rijn/smart-blind-control/control_board/datasheets/diagram.png

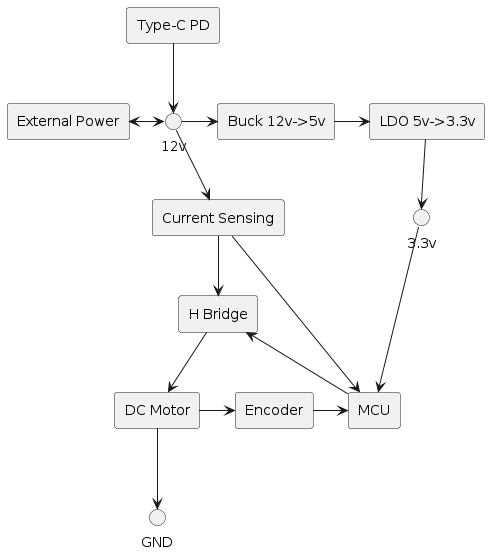
control_board/datasheets/diagram.png
