rijn/smart-blind-control/control_board/datasheets/O1CN01RWz3fV1wqTMmvift8_!!2208043386359.jpg

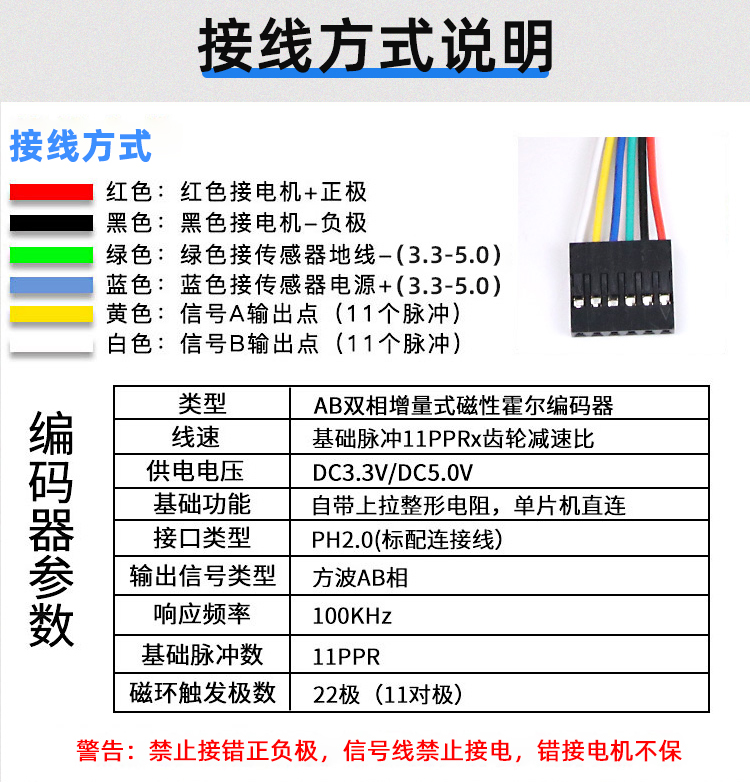
control_board/datasheets/O1CN01RWz3fV1wqTMmvift8_!!2208043386359.jpg
