rijn/smart-blind-control/(list of files, cad)

Other CAD files:
case/blind control.f3z
