rijn/smart-blind-control/control_board/control_board.kicad_pcb

## KiCad design control_board/control_board.kicad_pcb (2024-06-19)

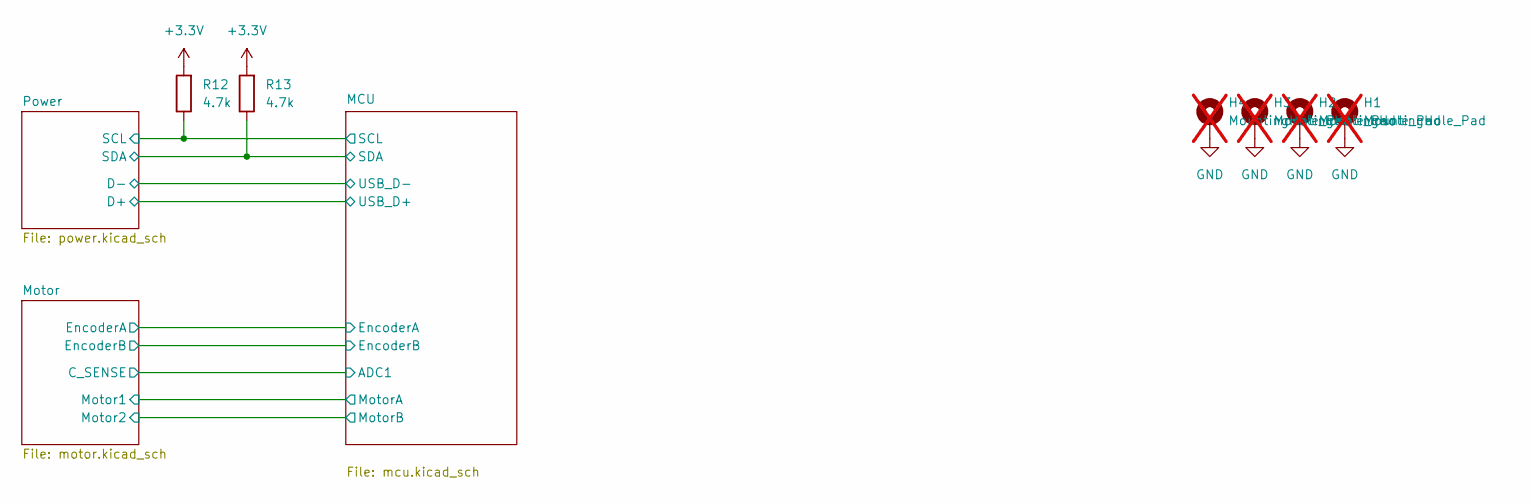
[picture p3: schematic control_board.kicad_sch]

Parts:
H1, H2, H3, H4: MountingHole_Pad; MountingHole_2.2mm_M2_Pad; not fitted
R12, R13: 4.7k; R_0603_1608Metric; LCSC Part# C23162

Connections:
+3.3V: R12.2, R13.2; also elsewhere on the board
/MCU/SCL: R12.1; also elsewhere on the board
/MCU/SDA: R13.1; also elsewhere on the board
GND: H1.1, H2.1, H3.1, H4.1; also elsewhere on the board

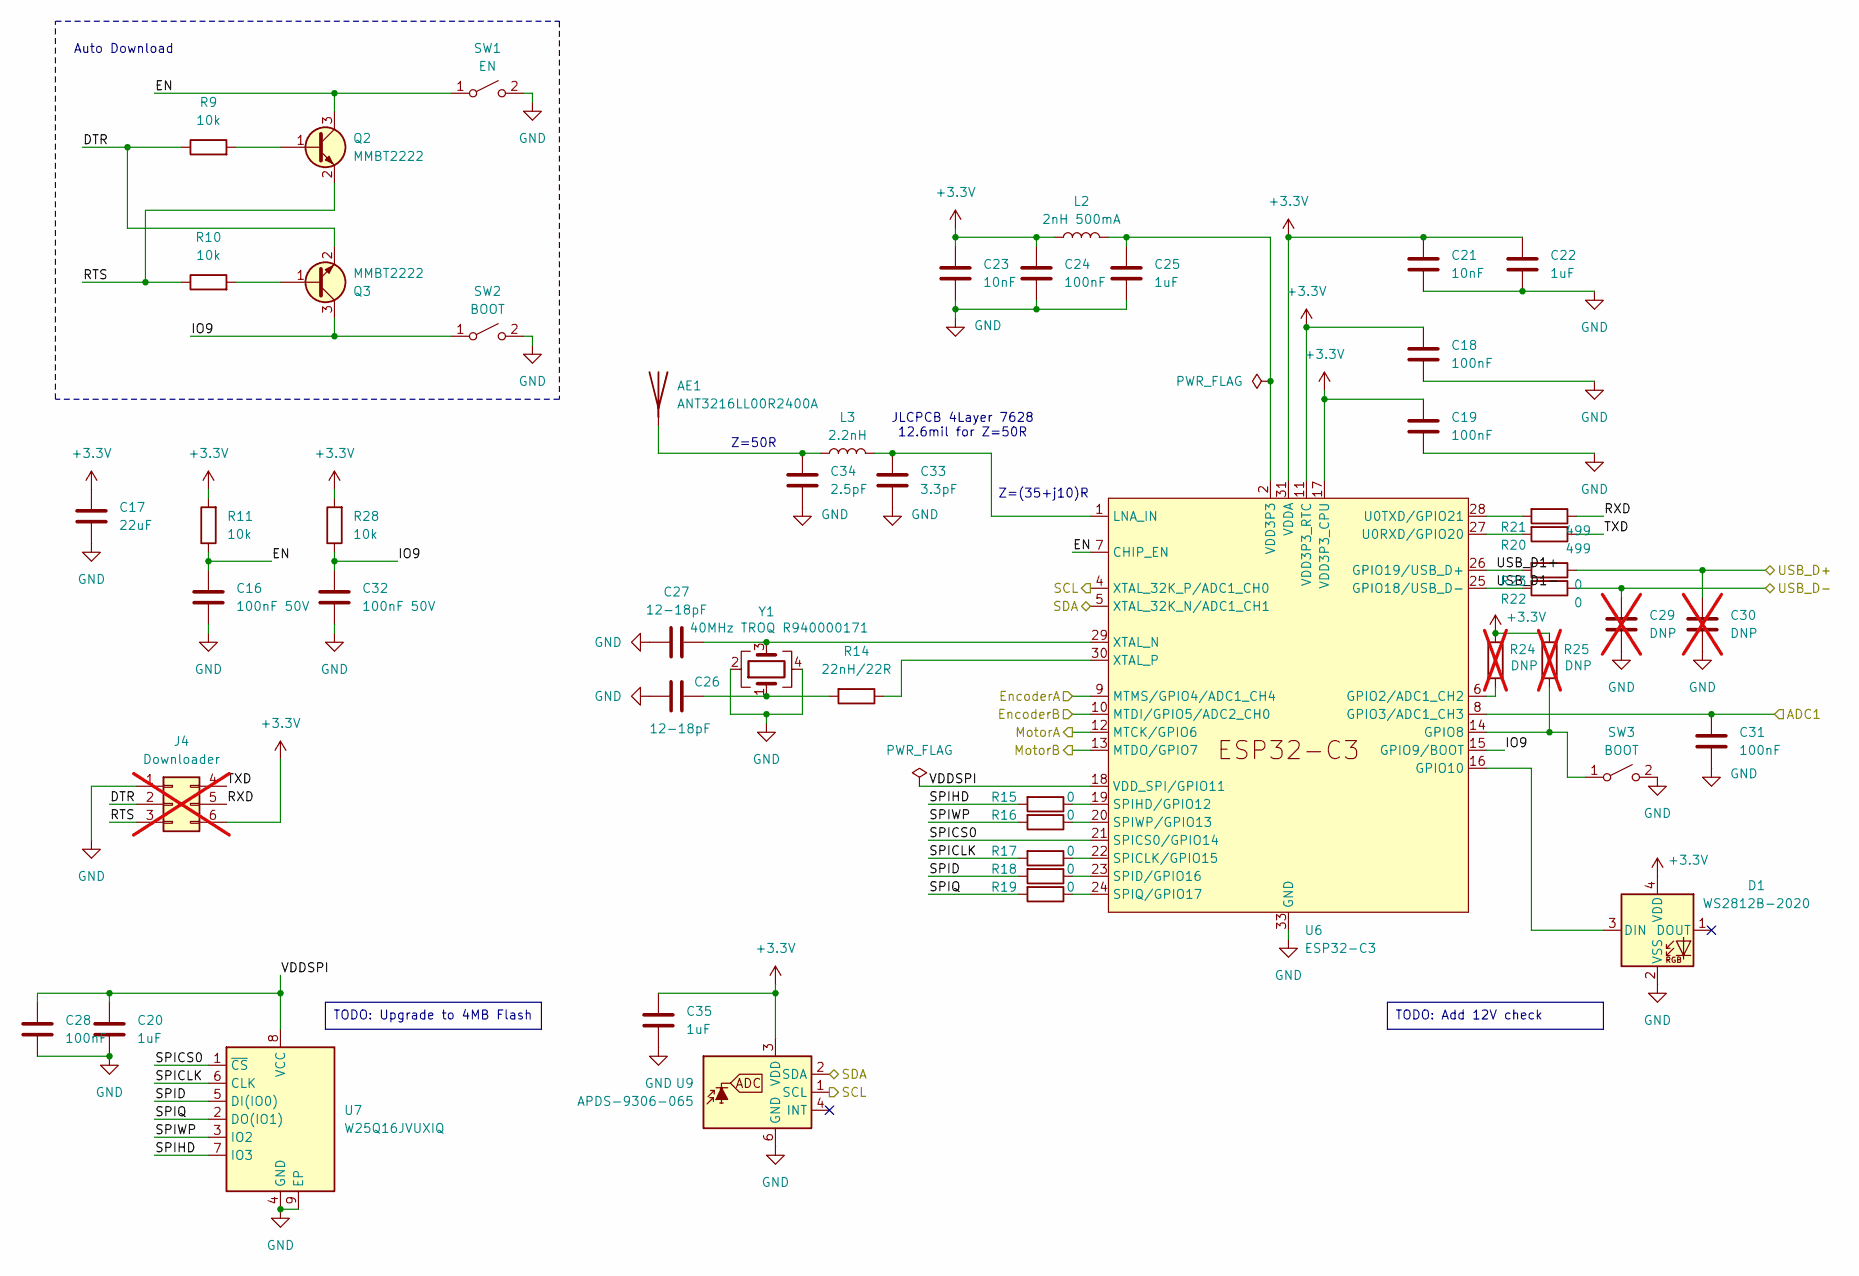
[picture p4: schematic mcu.kicad_sch]

Parts:
AE1: ANT3216LL00R2400A; LCSC Part# C293767
C16, C32: 100nF 50V; C_0603_1608Metric; LCSC Part# C14663
C17: 22uF; C_0805_2012Metric; LCSC Part# C45783
C18, C19, C24, C28, C31: 100nF; C_0603_1608Metric; LCSC Part# C14663
C20, C22, C25, C35: 1uF; C_0603_1608Metric; LCSC Part# C15849
C21, C23: 10nF; C_0603_1608Metric; LCSC Part# C57112
C26, C27: 12-18pF; C_0603_1608Metric; LCSC Part# C38523
C29, C30: DNP; C_0603_1608Metric; not fitted
C33: 3.3pF; C_0402_1005Metric; LCSC Part# C710652
C34: 2.5pF; C_0402_1005Metric; LCSC Part# C2189359
D1: WS2812B-2020; LED_WS2812B-2020_PLCC4_2.0x2.0mm; LCSC Part# C5349955
J4: Downloader; PinHeader_2x03_P2.54mm_Vertical; not fitted
L2: 2nH 500mA; L_0603_1608Metric; LCSC Part# C280268
L3: 2.2nH; L_0402_1005Metric; LCSC Part# C86061
Q2, Q3: MMBT2222; SOT-23; LCSC Part# C8512
R9, R10, R11, R28: 10k; R_0603_1608Metric; LCSC Part# C25804
R14: 22nH/22R; R_0603_1608Metric; LCSC Part# C23345
R15, R16, R17, R18, R19: 0; R_0402_1005Metric; LCSC Part# C17168
R20, R21: 499; R_0603_1608Metric; LCSC Part# C23193
R22, R23: 0; R_0603_1608Metric; LCSC Part# C21189
R24, R25: DNP; R_0603_1608Metric; not fitted
SW1: EN; SW_SPST_CK_KMS2xxGP; LCSC Part# C221701
SW2, SW3: BOOT; SW_SPST_CK_KMS2xxGP; LCSC Part# C221701
U6: ESP32-C3; QFN-32-1EP_5x5mm_P0.5mm_EP3.45x3.45mm; LCSC Part# C2838500
U7: W25Q16JVUXIQ; Winbond_USON-8-1EP_3x2mm_P0.5mm_EP0.2x1.6mm; LCSC Part# C2843335
U9: APDS-9306-065; Broadcom_DFN-6_2x2mm_P0.65mm; LCSC Part # C2649498
Y1: 40MHz TROQ R940000171; Crystal_SMD_2016-4Pin_2.0x1.6mm; LCSC Part# C2929402

Connections:
+3.3V: C17.1, C18.1, C19.1, C21.1, C22.1, C23.1, C24.1, C35.1, D1.4 (VDD), J4.6, L2.1, R11.2, R24.1, R25.1, R28.2, U6.11 (VDD3P3_RTC), U6.17 (VDD3P3_CPU), U6.31 (VDDA), U6.32 (VDDA), U9.3 (VDD); also elsewhere on the board
/MCU/ADC1: C31.1, U6.8 (GPIO3/ADC1_CH3); also elsewhere on the board
/MCU/DTR: J4.2, Q3.2 (E), R9.1
/MCU/EN: C16.1, Q2.3 (C), R11.1, SW1.1 (A), U6.7 (CHIP_EN)
/MCU/EncoderA: U6.9 (MTMS/GPIO4/ADC1_CH4); also elsewhere on the board
/MCU/EncoderB: U6.10 (MTDI/GPIO5/ADC2_CH0); also elsewhere on the board
/MCU/IO9: C32.1, Q3.3 (C), R28.1, SW2.1 (A), U6.15 (GPIO9/BOOT)
/MCU/MotorA: U6.12 (MTCK/GPIO6); also elsewhere on the board
/MCU/MotorB: U6.13 (MTDO/GPIO7); also elsewhere on the board
/MCU/RTS: J4.3, Q2.2 (E), R10.1
/MCU/RXD: J4.5, R21.1
/MCU/SCL: U6.4 (XTAL_32K_P/ADC1_CH0), U9.1 (SCL); also elsewhere on the board
/MCU/SDA: U6.5 (XTAL_32K_N/ADC1_CH1), U9.2 (SDA); also elsewhere on the board
/MCU/SPICLK: R17.2, U7.6 (CLK)
/MCU/SPICS0: U6.21 (SPICS0/GPIO14), U7.1 (~CS)
/MCU/SPID: R18.2, U7.5 (DI(IO0))
/MCU/SPIHD: R15.2, U7.7 (IO3)
/MCU/SPIQ: R19.2, U7.2 (DO(IO1))
/MCU/SPIWP: R16.2, U7.3 (IO2)
/MCU/TXD: J4.4, R20.1
/MCU/USB_D1+: R23.2, U6.26 (GPIO19/USB_D+)
/MCU/USB_D1-: R22.2, U6.25 (GPIO18/USB_D-)
/MCU/USB_D+: C30.1, R23.1; also elsewhere on the board
/MCU/USB_D-: C29.1, R22.1; also elsewhere on the board
/MCU/VDDSPI: C20.1, C28.1, U6.18 (VDD_SPI/GPIO11), U7.8 (VCC)
GND: C16.2, C17.2, C18.2, C19.2, C20.2, C21.2, C22.2, C23.2, C24.2, C25.2, C26.1, C27.1, C28.2, C29.2, C30.2, C31.2, C32.2, C33.2, C34.2, C35.2, D1.2 (VSS), J4.1, SW1.2 (B), SW2.2 (B), SW3.2 (B), U6.33 (GND), U7.4 (GND), U7.9 (EP), U9.6 (GND), Y1.2, Y1.4; also elsewhere on the board
unnamed: AE1.1 (A), C34.1, L3.1
unnamed: C25.1, L2.2, U6.2 (VDD3P3), U6.3 (VDD3P3)
unnamed: C26.2, R14.2, Y1.1
unnamed: D1.3 (DIN), U6.16 (GPIO10)
unnamed: Q2.1 (B), R9.2
unnamed: Q3.1 (B), R10.2
unnamed: R25.2, SW3.1 (A), U6.14 (GPIO8)
unnamed: R24.2, U6.6 (GPIO2/ADC1_CH2)
unnamed: C33.1, L3.2, U6.1 (LNA_IN)
unnamed: R17.1, U6.22 (SPICLK/GPIO15)
unnamed: R18.1, U6.23 (SPID/GPIO16)
unnamed: R15.1, U6.19 (SPIHD/GPIO12)
unnamed: R19.1, U6.24 (SPIQ/GPIO17)
unnamed: R16.1, U6.20 (SPIWP/GPIO13)
unnamed: R20.2, U6.27 (U0RXD/GPIO20)
unnamed: R21.2, U6.28 (U0TXD/GPIO21)
unnamed: C27.2, U6.29 (XTAL_N), Y1.3
unnamed: R14.1, U6.30 (XTAL_P)

Notes on the sheet:
TODO: Add 12V check
TODO: Upgrade to 4MB Flash
JLCPCB 4Layer 7628 12.6mil for Z=50R
Z=50R
Auto Download
Z=(35+j10)R

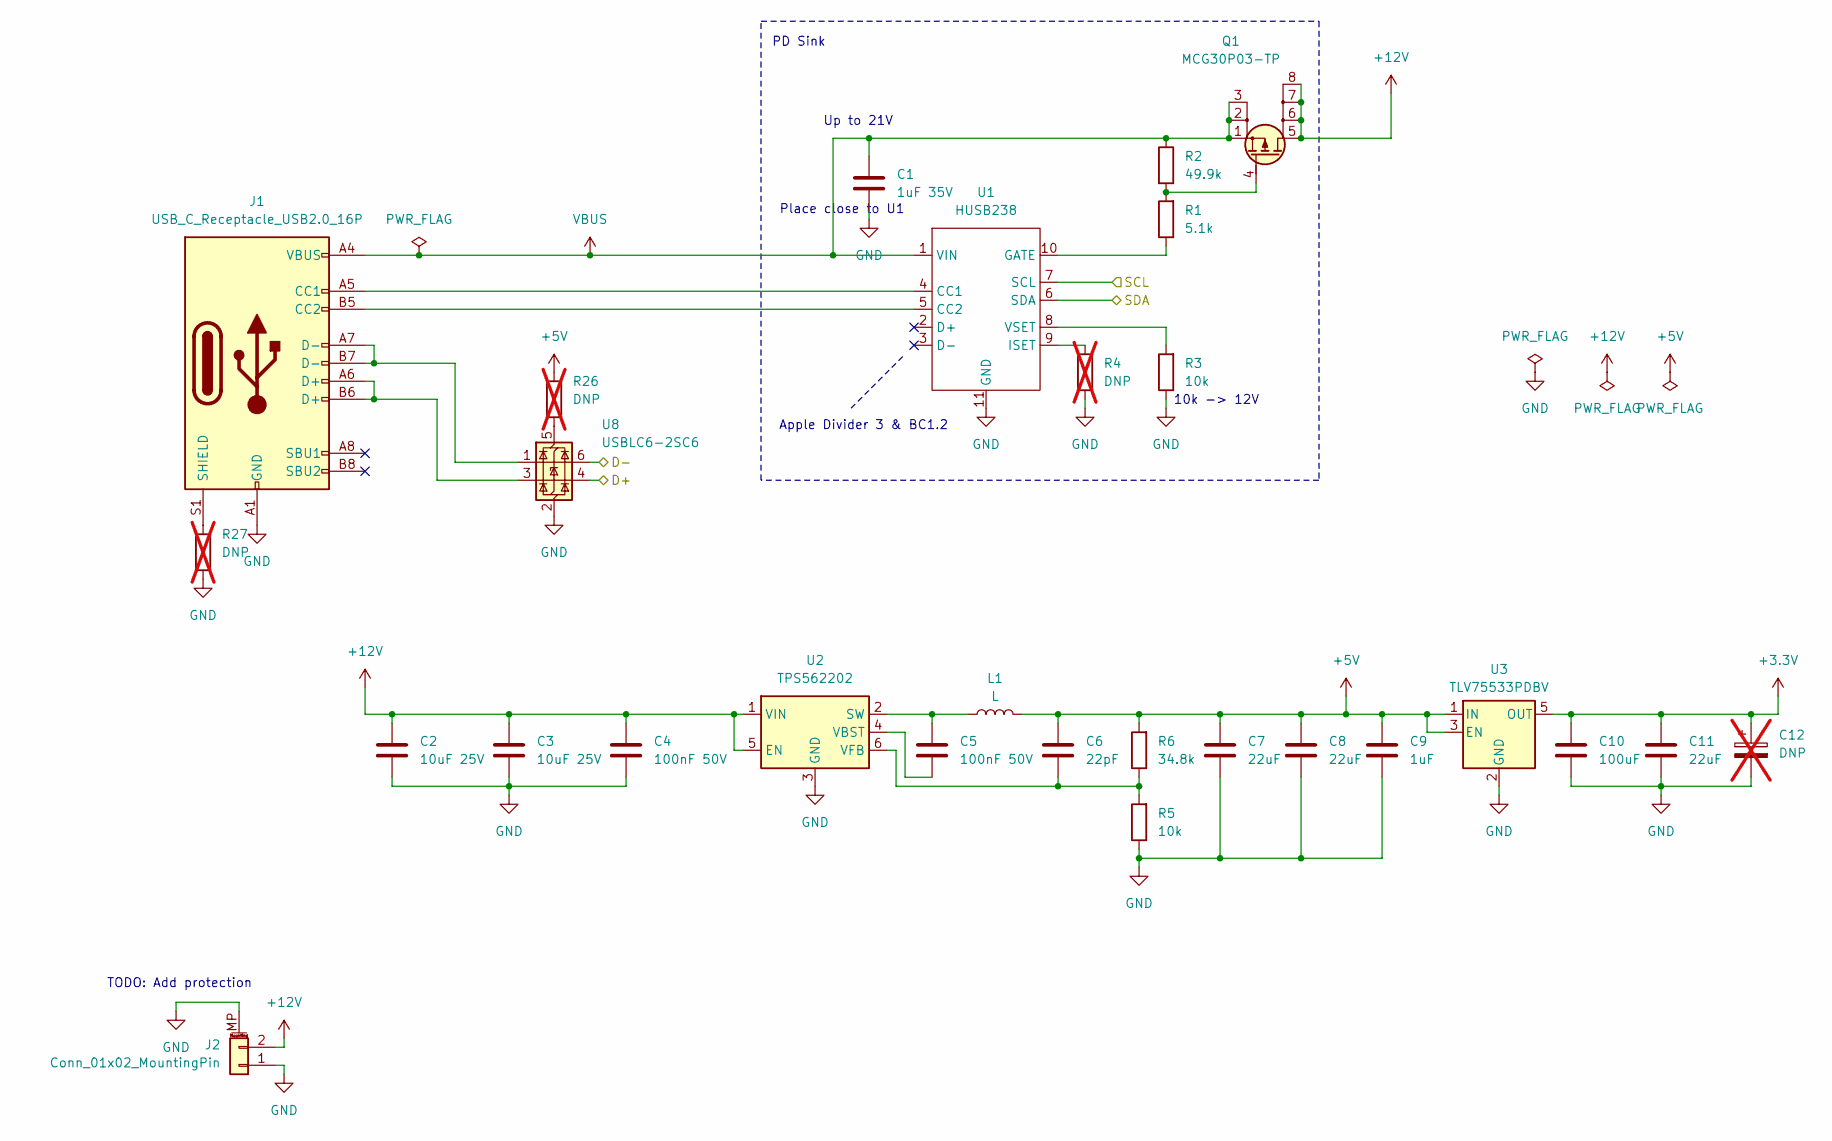
[picture p5: schematic power.kicad_sch]

Parts:
C1: 1uF 35V; C_0603_1608Metric; LCSC Part# C15849
C2, C3: 10uF 25V; C_0805_2012Metric; LCSC Part# C15850
C4, C5: 100nF 50V; C_0603_1608Metric; LCSC Part# C14663
C6: 22pF; C_0603_1608Metric; LCSC Part# C1653
C7, C8, C11: 22uF; C_0805_2012Metric; LCSC Part# C45783
C9: 1uF; C_0603_1608Metric; LCSC Part# C15849
C10: 100uF; C_1206_3216Metric; LCSC Part# C15008
C12: DNP; CP_EIA-3216-10_Kemet-I; not fitted
J1: USB_C_Receptacle_USB2.0_16P; USB_C_Receptacle_G-Switch_GT-USB-7010ASV; LCSC Part# C165948
J2: Conn_01x02_MountingPin; AMASS_XT30PW-M_1x02_P2.50mm_Horizontal
L1: L; L_KOHERelec_MDA5030; LCSC Part# C2847477
Q1: MCG30P03-TP; DFN3333; LCSC Part# C6666543
R1: 5.1k; R_0603_1608Metric; LCSC Part# C23186
R2: 49.9k; R_0603_1608Metric; LCSC Part# C23184
R3, R5: 10k; R_0603_1608Metric; LCSC Part# C25804
R4, R26, R27: DNP; R_0603_1608Metric; not fitted
R6: 34.8k; R_0603_1608Metric; LCSC Part# C23141
U1: HUSB238; DFN-10-1EP_3x3mm_P0.5mm_EP1.7x2.5mm; LCSC Part# C7471904
U2: TPS562202; SOT-563; LCSC Part# C2877547
U3: TLV75533PDBV; SOT-23-5; LCSC Part# C404027
U8: USBLC6-2SC6; SOT-23-6; LCSC Part# C2827654

Connections:
+3.3V: C10.1, C11.1, C12.1, U3.5 (OUT); also elsewhere on the board
+5V: C6.1, C7.1, C8.1, C9.1, L1.2, R6.2, R26.2, U3.1 (IN), U3.3 (EN)
+12V: C2.1, C3.1, C4.1, J2.2, Q1.5 (D), Q1.6 (D), Q1.7 (D), Q1.8 (D), U2.1 (VIN), U2.5 (EN); also elsewhere on the board
/MCU/SCL: U1.7 (SCL); also elsewhere on the board
/MCU/SDA: U1.6 (SDA); also elsewhere on the board
/MCU/USB_D+: U8.4 (I/O2); also elsewhere on the board
/MCU/USB_D-: U8.6 (I/O1); also elsewhere on the board
GND: C1.2, C2.2, C3.2, C4.2, C7.2, C8.2, C9.2, C10.2, C11.2, C12.2, J1.A1 (GND), J1.A12 (GND), J1.B1 (GND), J1.B12 (GND), J2.1, J2.MP (MountPin), R3.1, R4.1, R5.1, R27.1, U1.11 (GND), U2.3 (GND), U3.2 (GND), U8.2 (GND); also elsewhere on the board
unnamed: J1.A5 (CC1), U1.4 (CC1)
unnamed: J1.B5 (CC2), U1.5 (CC2)
unnamed: J1.A6 (D+), J1.B6 (D+), U8.3 (I/O2)
unnamed: J1.A7 (D-), J1.B7 (D-), U8.1 (I/O1)
unnamed: J1.S1 (SHIELD), R27.2
unnamed: Q1.4 (G), R1.2, R2.2
unnamed: R1.1, U1.10 (GATE)
unnamed: R4.2, U1.9 (ISET)
unnamed: R3.2, U1.8 (VSET)
unnamed: C5.1, L1.1, U2.2 (SW)
unnamed: C5.2, U2.4 (VBST)
unnamed: C6.2, R5.2, R6.1, U2.6 (VFB)
unnamed: R26.1, U8.5 (VBUS)
VBUS: C1.1, J1.A4 (VBUS), J1.A9 (VBUS), J1.B4 (VBUS), J1.B9 (VBUS), Q1.1 (S), Q1.2 (S), Q1.3 (S), R2.1, U1.1 (VIN)

Notes on the sheet:
TODO: Add protection
10k -> 12V
PD Sink
Apple Divider 3 & BC1.2
Place close to U1
Up to 21V

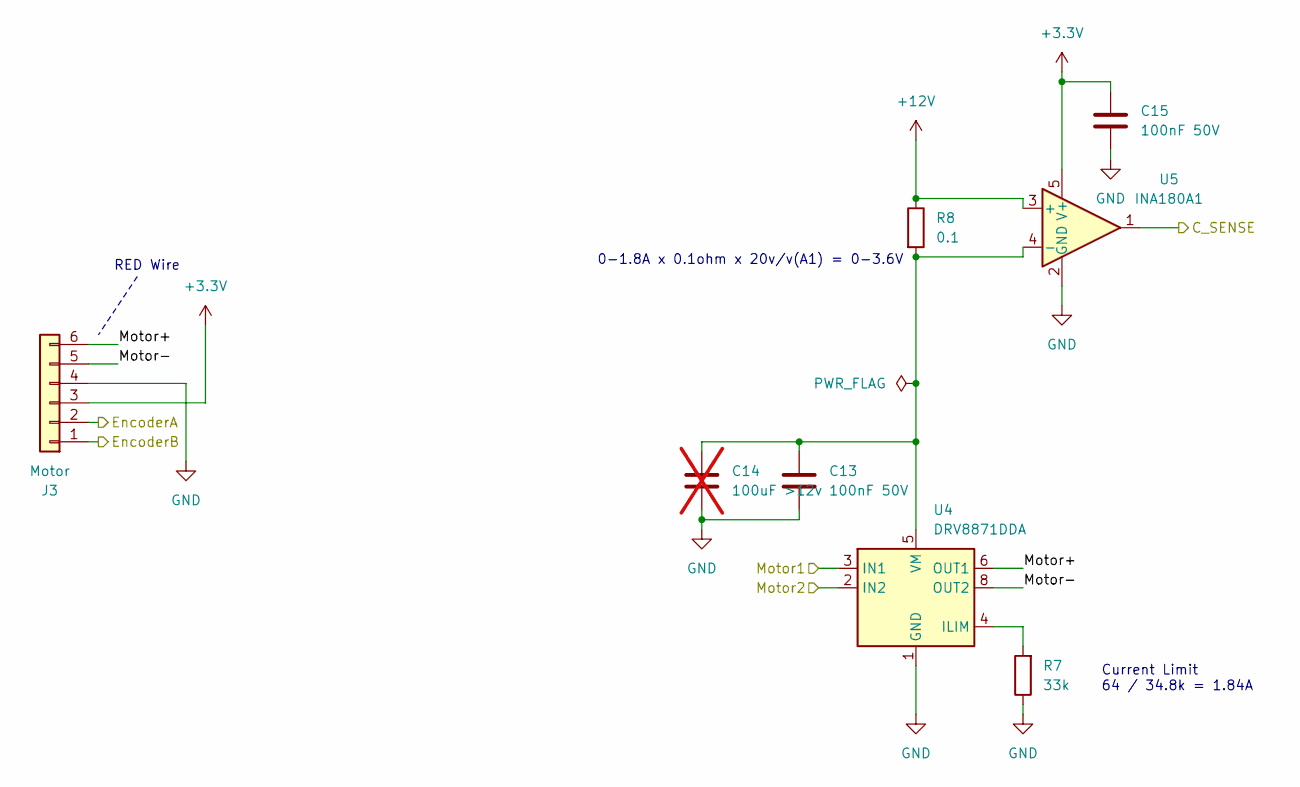
[picture p6: schematic motor.kicad_sch]

Parts:
C13, C15: 100nF 50V; C_0603_1608Metric; LCSC Part# C14663
C14: 100uF >12v; C_1206_3216Metric; not fitted
J3: Motor; PinHeader_1x06_P2.54mm_Horizontal
R7: 33k; R_0603_1608Metric; LCSC Part# C4216
R8: 0.1; R_2512_6332Metric; LCSC Part# C160587
U4: DRV8871DDA; Texas_HTSOP-8-1EP_3.9x4.9mm_P1.27mm_EP2.95x4.9mm_Mask2.4x3.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; LCSC Part# C75864
U5: INA180A1; SOT-23-5; LCSC Part# C122228

Connections:
+3.3V: C15.1, J3.3, U5.5 (V+); also elsewhere on the board
+12V: R8.1, U5.3 (+); also elsewhere on the board
/MCU/ADC1: U5.1; also elsewhere on the board
/MCU/EncoderA: J3.2; also elsewhere on the board
/MCU/EncoderB: J3.1; also elsewhere on the board
/MCU/MotorA: U4.3 (IN1); also elsewhere on the board
/MCU/MotorB: U4.2 (IN2); also elsewhere on the board
/Motor/Motor+: J3.6, U4.6 (OUT1)
/Motor/Motor-: J3.5, U4.8 (OUT2)
GND: C13.2, C14.2, C15.2, J3.4, R7.1, U4.1 (GND), U4.7 (GND), U4.9 (GND), U5.2 (GND); also elsewhere on the board
unnamed: R7.2, U4.4 (ILIM)
unnamed: C13.1, C14.1, R8.2, U4.5 (VM), U5.4 (-)

Notes on the sheet:
RED Wire
Current Limit 64 / 34.8k = 1.84A
0-1.8A x 0.1ohm x 20v/v(A1) = 0-3.6V

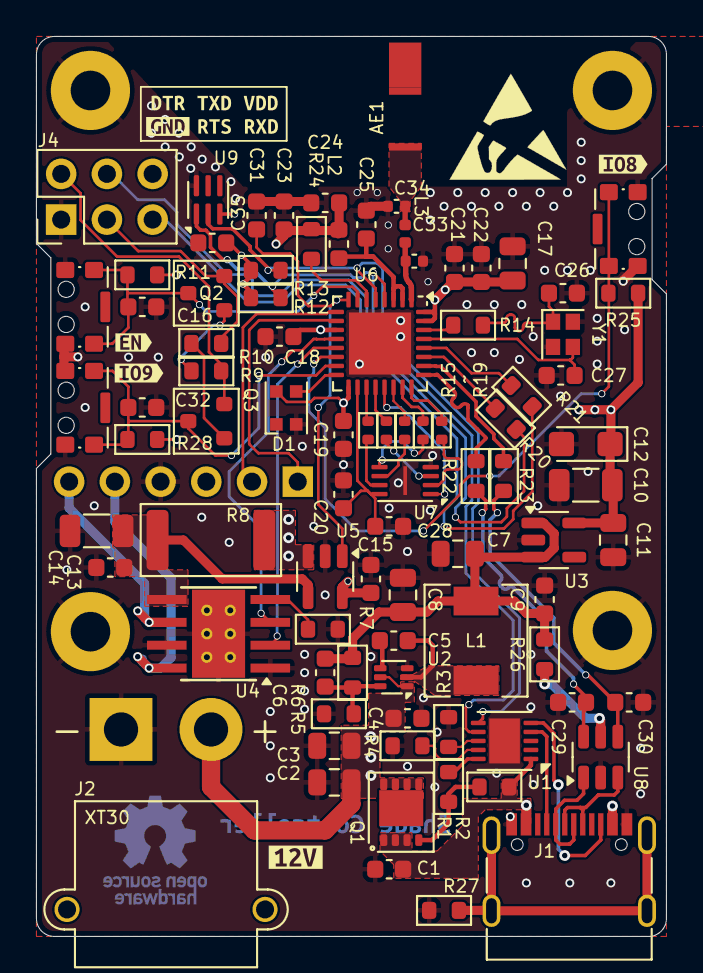
[picture p7: board control_board.kicad_pcb from above]

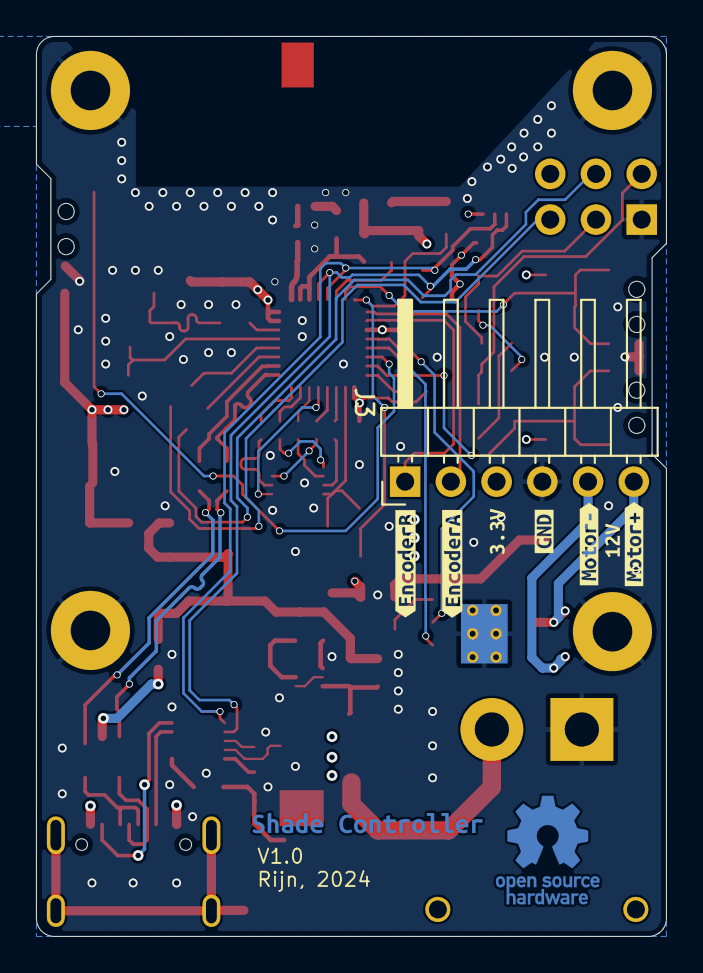
[picture p8: board control_board.kicad_pcb from below]

Board: 4 copper layers, 35.0 x 50.0 mm, 108 parts (9 on the bottom side), 64 nets.

Other parts of the board:
kibuzzard-665CCFF4: G***; kibuzzard-665CCFF4
kibuzzard-665CD0B9: G***; kibuzzard-665CD0B9
kibuzzard-665CD1AF: G***; kibuzzard-665CD1AF
kibuzzard-665CD19E: G***; kibuzzard-665CD19E
kibuzzard-665CD023: G***; kibuzzard-665CD023
kibuzzard-665CD72A: G***; kibuzzard-665CD72A
kibuzzard-665CD082: G***; kibuzzard-665CD082
kibuzzard-665CD156: G***; kibuzzard-665CD156
kibuzzard-665CD192: G***; kibuzzard-665CD192
kibuzzard-665CD205: G***; kibuzzard-665CD205
kibuzzard-665CD237: G***; kibuzzard-665CD237
kibuzzard-665CD246: G***; kibuzzard-665CD246
kibuzzard-665CD251: G***; kibuzzard-665CD251
kibuzzard-665CD268: G***; kibuzzard-665CD268
kibuzzard-665CD276: G***; kibuzzard-665CD276
kibuzzard-665CD288: G***; kibuzzard-665CD288
