rijn/smart-blind-control/(commit log)

2024-06-19 Upload v1.0 control board
    [control_board.kicad_pcb, control_board.kicad_sch, interface.kicad_sch, mcu.kicad_sch, motor.kicad_sch, power.kicad_sch]
2024-06-19 Upload v43 case design
    [blind control.f3z]
